urish/tt-simon-game/docs/info.md

Simon Says Game

## How it works

Simon says is a simple electronic memory game: the user has to repeat a growing sequence of colors.
The sequence is displayed by lighting up the LEDs. Each color also has a corresponding tone.

In each turn, the game will play the sequence, and then wait for the user to repeat the sequence
by pressing the buttons according to the color sequence.
If the user repeated the sequence correctly, the game will play a "leveling-up" sound,
add a new color at the end of the sequence, and move to the next turn.

The game continues until the user has made a mistake. Then a game over sound is played, and the game restarts.

Check out the online simulation at https://wokwi.com/projects/408757730664700929 (including wiring diagram).

## Clock settings

The `clk_sel` input selects the clock source:
- `0`: external 50 KHz clock, provided through the `clk` input.
- `1`: internal clock, generated by the `ring_osc` module, with a frequency of ~56 kHz.

The internal clock is generated by a 13-stage ring oscillator, oscillating at ~457 MHz, as measured on TTIHP25a silicon. It is then divided by 8192 to land near the 50 kHz of the external-clock case.

The ring oscillator only runs while `clk_sel` is high, so it costs nothing when the external clock is used.

When using the internal clock, its signal is also output on the `uo_out[7]` pin for debugging purposes.

## How to test

Use a [Simon Says Pmod](https://github.com/urish/tt-simon-pmod) to test the game.

Provide a 50 KHz clock input, reset the game, and enjoy!

If you don't have the Pmod, you can still connect the hardware manually as follows:

1. Connect the four push buttons to pins `btn1`, `btn2`, `btn3`, and `btn4`.
   Also connect each button to a pull down resistor.
2. Connect the LEDs to pins `led1`, `led2`, `led3`, and `led4`, matching
   the colors of the buttons (so `led1` and `btn1` have the same color, etc.).
   Don't forget current-limiting resistors!
3. Connect the speaker to the `speaker` pin (optional).
4. Connect the seven segment display as follows: `seg_a` through `sev_g` to
   individual segments, `dig1` to the common pin of the tens digit, `dig2`
   to the common pin of the ones digit.
   Set `seginv` according to the type of 7 segment display you have: high
   for common anode, low for common cathode.
5. Reset the game, and then press any button to start it. Enjoy!

## External Hardware

[Simon Says Pmod](https://github.com/urish/tt-simon-pmod) or four push buttons (with pull-down resistors), four LEDs, and optionally a speaker/buzzer and two digit 7-segment display.
