urish/tt-simon-game/test/tb.v

`default_nettype none
`timescale 1ns / 1ps

/* This testbench just instantiates the module and makes some convenient wires
   that can be driven / tested by the cocotb test.py.
*/
module tb ();

  // Dump the signals to a VCD file. You can view it with gtkwave.
  `ifndef NO_VCD
  initial begin
    $dumpfile("tb.vcd");
    $dumpvars(0, tb);
    #1;
  end
  `endif

  // inputs from testbench
  reg [3:0] btn;
  reg seginv;

  // Wire up the inputs and outputs:
  reg clk;
  reg rst_n;
  reg ena;
  wire [7:0] ui_in = {3'b000, seginv, btn};
  wire [7:0] uio_in;
  wire [7:0] uo_out;
  wire [7:0] uio_out;
  wire [7:0] uio_oe;

  wire [3:0] led = uo_out[3:0];
  wire speaker = uo_out[4];
  wire dig1 = uo_out[5];
  wire dig2 = uo_out[6];
  wire [6:0] seg = uio_out[6:0] & uio_oe[6:0];

  tt_um_urish_simon user_project (
      .ui_in  (ui_in),    // Dedicated inputs
      .uo_out (uo_out),   // Dedicated outputs
      .uio_in (uio_in),   // IOs: Input path
      .uio_out(uio_out),  // IOs: Output path
      .uio_oe (uio_oe),   // IOs: Enable path (active high: 0=input, 1=output)
      .ena    (ena),      // enable - goes high when design is selected
      .clk    (clk),      // clock
      .rst_n  (rst_n)     // not reset
  );

endmodule
