urish/tt-simon-game/(commit log)

2025-09-24 fix: remove "RT_MAX_LAYER" from config.json
    It's already configured by tt-support-tool according to the current PDK. Removing it from the per-project config.json makes projects more portable between different tech nodes.
2025-12-02 perf(sound_gen): remove 16 unused flops
    Reduce flop usage by reducing the `tick_counter` width from 32 bits to 16 bits.
    We can probably even get away with just 15 bits, given that the highest clock frequency we currently support is 63 KHz.
2025-12-02 perf: remove 10 flops
    Trim `ticks_per_milli` from 16 bits down to 6 bits, given that the max clock frequency we currently support is 63 KHz.
2025-12-02 feat: spice simulation for the gated ring_osc
    [ring_osc.sch]
2026-08-25 fix(ring_osc): set DIVIDER_BITS to 13 to match measured ttihp25a silicon
    TTIHP25a measured 27.9 kHz on uo_out[7], which with the /16384 divider means a ~457 MHz ring - about half of the ~900 MHz the xschem simulation predicted before the tapeout.
    Calibrating the divider accordingly:
    457 MHz / 8192 = 55.8 kHz
    [project.v]
